M4tof/Chwytak-L.A.P.A-/README.md

Nagranie o projekcie: https://youtu.be/8SAvqdIeHKM?si=LI6djmvqu2JU0hMP
